anmanhani-ai/robot/raspberry_pi/AgriBot Calibration - Camera Preview_screenshot_14.01.2026.png

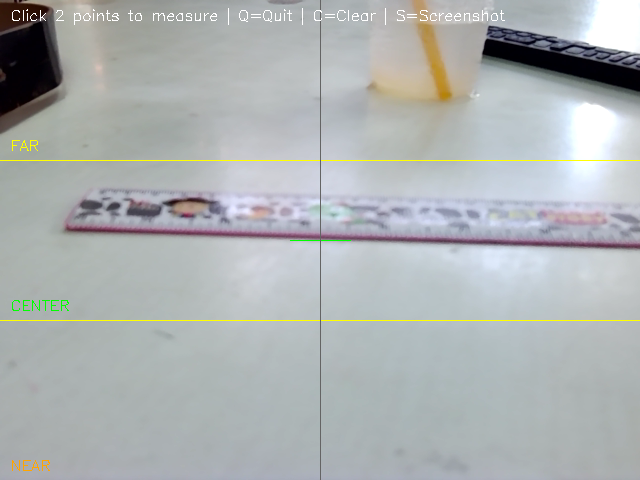
raspberry_pi/AgriBot Calibration - Camera Preview_screenshot_14.01.2026.png
