anmanhani-ai/robot/raspberry_pi/CALIBRATION_GUIDE.md

# 📐 AgriBot Calibration Guide

คู่มือการ Calibrate ระบบหุ่นยนต์กำจัดวัชพืช AgriBot

---

## 📋 สารบัญ

1. [ภาพรวม](#ภาพรวม)
2. [การติดตั้งกล้อง](#การติดตั้งกล้อง)
3. [ขั้นตอนการ Calibrate](#ขั้นตอนการ-calibrate)
4. [การวัด Pixel to CM](#การวัด-pixel-to-cm)
5. [การ Calibrate แขนกล](#การ-calibrate-แขนกล)
6. [การใช้งาน Encoder](#การใช้งาน-encoder)
7. [Troubleshooting](#troubleshooting)

---

## ภาพรวม

### ทำไมต้อง Calibrate?

ระบบ AgriBot ใช้กล้องตรวจจับวัชพืช แล้วคำนวณระยะทางจาก **pixel** เป็น **cm** เพื่อสั่งให้แขนกลยืดไปพ่นยา

```
กล้อง → ตรวจจับหญ้า (pixel) → คำนวณระยะ (cm) → สั่งแขนยืด
```

ค่า Calibration ที่สำคัญ:

| ค่า | ความหมาย | ผลกระทบถ้าผิด |
|-----|---|---|
| `pixel_to_cm_z` | 1 pixel = กี่ cm | แขนยืดสั้น/ยาวเกินไป |
| `arm_offset` | ระยะระหว่างกล้องกับแขน | พ่นผิดจุด |
| `arm_speed` | ความเร็วแขน (cm/s) | เวลาไม่ตรง |

---

## การติดตั้งกล้อง

### องศากล้อง

```
        📷 กล้อง                     📷 กล้อง
         │ (0°)                       ╲ (45°)
         │                             ╲
         ▼                              ╲
    ═══════════                    ═══════════
        พื้น                           พื้น
    
    Top-down (แนะนำ)              เฉียง (ต้อง calibrate)
```

| องศา | ข้อดี | ข้อเสีย |
|---|---|---|
| 0° (มองลง) | pixel_to_cm เท่ากันทั้งภาพ | ต้องติดตั้งสูง |
| 30-45° | ติดตั้งง่าย, เห็นมุมกว้าง | pixel_to_cm ไม่เท่ากัน |
| 60°+ | - | ไม่แนะนำ |

### ความสูงกล้อง

- **แนะนำ:** 40-60 cm จากพื้น
- **ต่ำเกินไป:** เห็นพื้นที่แคบ
- **สูงเกินไป:** รายละเอียดหาย

---

## ขั้นตอนการ Calibrate

### 1. เตรียมอุปกรณ์

- [ ] ไม้บรรทัด (แนะนำ 30 cm)
- [ ] กระดาษขาว A4 (ช่วยให้เห็นชัด)
- [ ] กล้องติดตั้งเรียบร้อย
- [ ] ESP32 เชื่อมต่อพร้อม

### 2. รัน Calibration Tool

```bash
cd raspberry_pi
python calibration_simple.py
```

เลือก `1. Full Calibration` สำหรับครั้งแรก

### 3. กรอกค่าตามขั้นตอน

- Tool จะถามค่าทีละส่วน
- กด Enter เพื่อใช้ค่า default
- ค่าจะบันทึกลง `calibration.json` อัตโนมัติ

---

## การวัด Pixel to CM

### สำหรับกล้องมองลงตรง (0°)

1. วางไม้บรรทัดในภาพ
2. ดูว่าระยะ 10 cm กินกี่ pixel
3. คำนวณ: `pixel_to_cm = 10 / จำนวน pixel`

### สำหรับกล้องเฉียง (30-60°)

เมื่อกล้องเฉียง ค่า pixel_to_cm จะ **ไม่เท่ากัน**:

```
┌───────────────────────────────┐
│ FAR (ส่วนบนภาพ)                │ ← pixel เล็ก
│ ต้นไม้ดูเล็ก                   │
│                               │
│ CENTER (กลางภาพ)              │ ← สำคัญที่สุด!
│ ตำแหน่งที่ target จะอยู่       │
│                               │
│ NEAR (ส่วนล่างภาพ)             │ ← pixel ใหญ่
│ ต้นไม้ดูใหญ่                   │
└───────────────────────────────┘
```

**วิธีวัด:**

1. วางไม้บรรทัดที่ **ส่วนล่าง** (NEAR) → จด pixel
2. วางไม้บรรทัดที่ **กลาง** (CENTER) → จด pixel ⭐
3. วางไม้บรรทัดที่ **ส่วนบน** (FAR) → จด pixel

Calibration Tool จะคำนวณค่าเฉลี่ยให้

> 💡 **สำคัญ:** ใช้ค่า **CENTER** สำหรับ Z-axis เพราะเป็นตำแหน่งที่ target จะอยู่เมื่อ aligned แล้ว

---

## การ Calibrate แขนกล

### Arm Offset (ระยะระหว่างกล้องกับแขน)

```
      กล้อง
        │
        │←── offset ──→│
        │              แขน
        ▼              ═══════→
      พื้น
```

**วิธีวัด:**
1. วัดระยะจากจุดกึ่งกลางเลนส์กล้อง ถึงจุดที่แขนเริ่มยืด
2. ใส่ค่าใน Calibration Tool

### Arm Speed (ความเร็วแขน)

> ⚠️ **หมายเหตุ:** ถ้าใช้ Encoder mode ไม่ต้องวัดค่านี้

**วิธีวัด:**
1. ทำเครื่องหมายจุดเริ่มต้น
2. ส่งคำสั่งผ่าน Serial Monitor:
   ```
   ACT:Z_OUT:1.00
   ```
3. วัดระยะที่ยืดได้ (cm)
4. คำนวณ: `speed = ระยะ / 1.00`

---

## การใช้งาน Encoder

### เมื่อไหร่ควรใช้ Encoder?

| Mode | ข้อดี | ข้อเสีย |
|---|---|---|
| **Time-based** | ไม่ต้องมี hardware | ไม่แม่นยำ 100% |
| **Encoder** | แม่นยำสูงมาก | ต้องติดตั้ง encoder |

### ค่าที่ต้องตั้ง

```
encoder_ppr = 20        # Pulses per revolution (ดูจาก spec)
wheel_diameter_mm = 30  # เส้นผ่านศูนย์กลางเพลาที่ encoder ต่ออยู่
```

### คำสั่ง Encoder บน ESP32

```
Z_MOVE:15.0   # เคลื่อนไป 15 cm
Z_HOME        # กลับตำแหน่ง 0
Z_POS         # อ่านตำแหน่งปัจจุบัน
Z_RESET       # Reset encoder เป็น 0
```

---

## Troubleshooting

### ❌ แขนยืดสั้นไป

- **สาเหตุ:** `pixel_to_cm_z` น้อยเกินไป หรือ `arm_offset` มากเกินไป
- **แก้ไข:** Re-calibrate ด้วยการวัดใหม่

### ❌ แขนยืดยาวเกินไป

- **สาเหตุ:** `pixel_to_cm_z` มากเกินไป
- **แก้ไข:** Re-calibrate, ตรวจสอบว่าวัด pixel ถูกต้อง

### ❌ พ่นไม่ตรงจุด (เลื่อนซ้ายขวา)

- **สาเหตุ:** ต้อง align ก่อนยืดแขน
- **แก้ไข:** ตรวจสอบ `alignment_tolerance_px`

### ❌ Encoder ไม่อ่านค่า

- **สาเหตุ:** สายหลุด หรือ pin ผิด
- **ตรวจสอบ:** 
  - ESP32 Pin: GPIO 34 (A), GPIO 35 (B)
  - ใช้คำสั่ง `Z_POS` ดูค่า

### ❌ ค่า pixel_to_cm ต่างกันมากระหว่าง Near/Far

- **สาเหตุ:** กล้องเฉียงมาก
- **แก้ไข:** ติดตั้งกล้องให้เฉียงน้อยลง (30-45°)

---

## 📁 ไฟล์ที่เกี่ยวข้อง

| ไฟล์ | หน้าที่ |
|---|---|
| `calibration_simple.py` | เครื่องมือ calibrate |
| `calibration.json` | เก็บค่า calibration (auto-save) |
| `robot_brain.py` | โหลดค่าจาก calibration.json |

---

## 📝 ตัวอย่าง calibration.json

```json
{
  "img_width": 640,
  "img_height": 480,
  "camera_angle_deg": 45.0,
  "camera_height_cm": 50.0,
  "pixel_to_cm_z": 0.052631,
  "pixel_to_cm_z_near": 0.045,
  "pixel_to_cm_z_center": 0.052631,
  "pixel_to_cm_z_far": 0.065,
  "arm_speed_cm_per_sec": 10.0,
  "arm_base_offset_cm": 5.0,
  "max_arm_extend_cm": 50.0,
  "calibrated_at": "2026-01-13T22:00:00",
  "calibrated_by": "AgriBot Team"
}
```

---

## ✅ Checklist ก่อนใช้งานจริง

- [ ] ติดตั้งกล้องมั่นคง
- [ ] Calibrate pixel_to_cm (วัด 3 จุด)
- [ ] วัด arm offset
- [ ] ทดสอบยืดแขน 1-2 ครั้ง
- [ ] ตรวจสอบค่าใน calibration.json
- [ ] Run ทดสอบใน manual mode ก่อน

---

**เขียนโดย:** AgriBot Team  
**Version:** 2.0  
**อัพเดท:** 2026-01-13
