anmanhani-ai/robot/esp32/AgriBot_ESP32/command_handler.h

/**
 * command_handler.h
 * จัดการคำสั่งจาก Raspberry Pi ผ่าน Serial
 */

#ifndef COMMAND_HANDLER_H
#define COMMAND_HANDLER_H

#include <Arduino.h>
#include "config.h"
#include "motor_z.h"
#include "motor_y.h"
#include "dual_motor.h"
#include "pump.h"
#include "ultrasonic.h"
#include "obstacle_avoidance.h"
#include "gpio_config.h"

class CommandHandler {
public:
    void init();
    void processCommand(String command);
    void stopAll();
    
private:
    void sendDone();
    void sendError(String message);
    float parseTime(String command);
    int parseInt(String command);
};

extern CommandHandler cmdHandler;

#endif // COMMAND_HANDLER_H
