anmanhani-ai/robot/(commit log)

2026-01-19 Add Manual Control Page + Fix ESP32 errors
    [AgriBot_ESP32.ino, button.cpp, button.h, buzzer.cpp, buzzer.h, calibration_simple.py, calibration_tool.py, cam.py]
2026-01-22 แก้ loop 3 s
2026-01-22 Add step tracking, processing lock, and z_base_offset_cm (7cm)
2026-01-22 Update calibration: wheel_speed=10.4, pixel_to_cm_z=0.0625, pixel_to_cm_x=0.046 with near/far values
2026-01-22 Fix: Y-axis motor uses duration, add debug prints for config values
    [robot_brain.py]
